hpretl/tt03-tempsensor/README.md

  

# Synthesizable Digital Temperature Sensor

**(c) 2023 Harald Pretl, Manuel Moser, and Michael Herber, Institute for Integrated Circuits, Johannes Kepler University, Linz, Austria**

This synthesized mixed-signal design is intended for inclusion in the **Tiny Tapeout 03** from **Matt Venn**. It implements a temperature sensor with a digital readout, implemented purely from digital standard cells using the `OpenLane`/`OpenROAD` RTL2GDS flow. The resolution is a relatively crude 5 degrees Celsius, but it spans a range of -30 to 120 degree Celsius. A block diagram of the Verilog-implemented design is shown below.

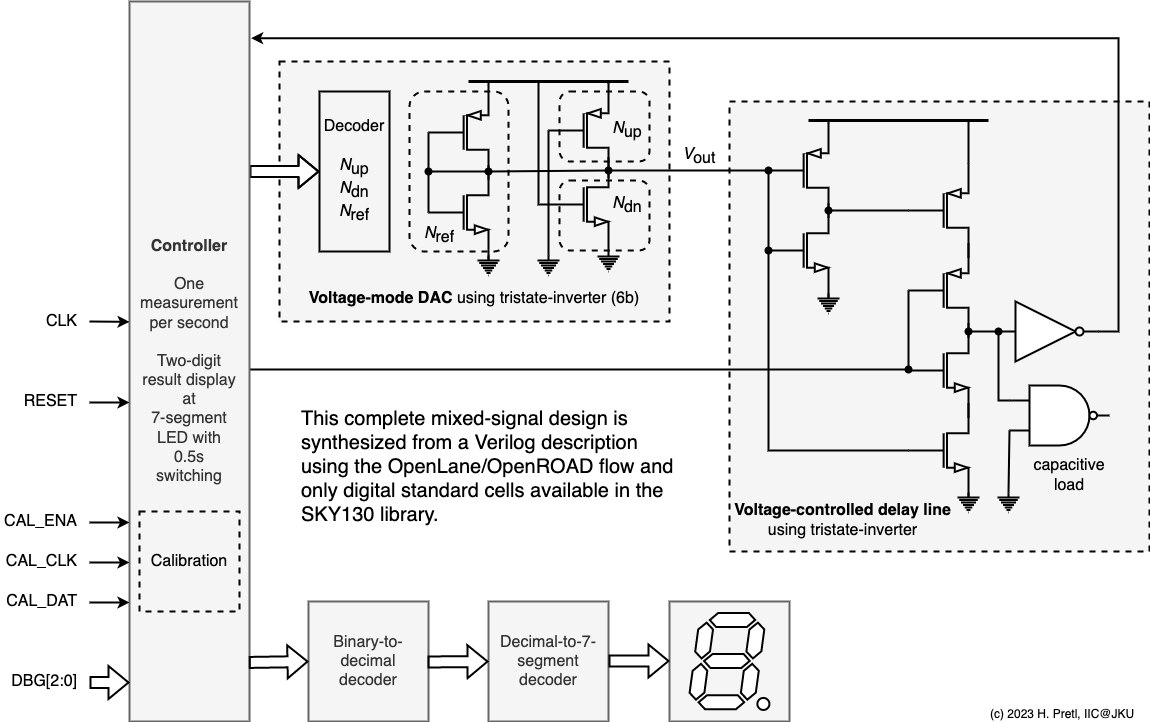
[picture p1: doc/synthesized_temperature_sensor.png]
Synthesized digital temperature sensor


The core of the circuit is the timed discharge of a pre-charged parasitic capacitor, where a MOSFET operated in subthreshold operation is used to set the strongly temperature-dependent discharge current. The subthreshold operation of a MOSFET is achieved by driving its gate with a voltage-mode digital-analog converter (DAC).

The DAC required for this temperature sensor is constructed from tristate-inverters, like the core discharge circuit. The concept of the DAC is shown in the figure below. Note that the $N_\mathrm{up}$ and the $N_\mathrm{dn}$ can be realized from the same instances by using the data inputs, whereas in the concept drawing, these are shown independently.

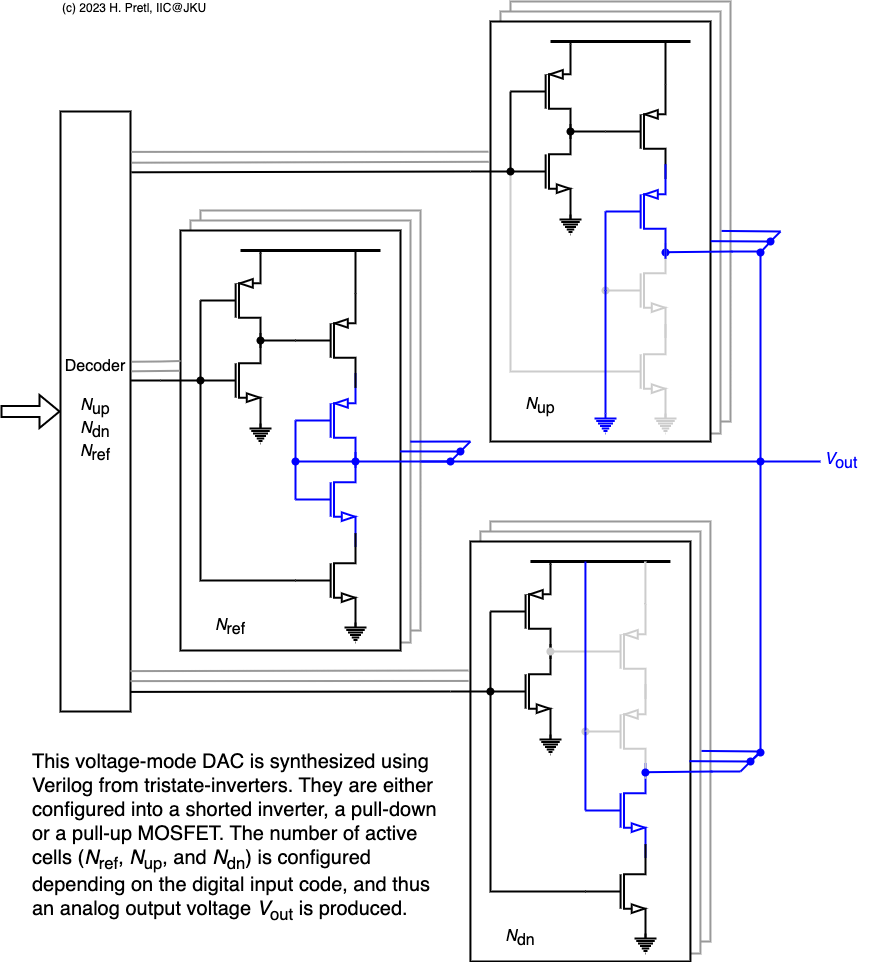
[picture p2: doc/voltage_dac.png]
Voltage-mode DAC


## What does it do?

A temperature-dependent code (a 6-bit binary value ranging from `0` to `63`) is output using an LED display in decimal mode, showing tens (dot off) and ones (dot on) (allowing a temperature range of `00` degree Celsius to `98` degree Celsius) with a measurement rate of ca. 1Hz and a display change rate of ca. 0.5Hz.

A calibration engine via a lookup table (LUT) is included to allow linearizing and calibrating the shown temperature code (the codes `0`...`31` can be translated into a code `00<<1`...`49<<1`). _(To cut the LUT size, the MSB of the raw temperature measurement is discarded, and an LSB of `0` is added to the LUT result, so only even results can be displayed.)_

Comprehensive debug modes are also implemented to monitor various internal states and signals.

## How does it work?

By creatively twisting the use of a tristate-inverter (`EINVP`), a low-resolution voltage DAC is built. This voltage-mode DAC is used in another twisted arrangement of an `EINVP` to bias an NMOS into subthreshold operation to discharge a pre-charged capacitor (the input capacitor of an inverter). Since the subthreshold current of a MOSFET is a strong function of temperature, the resulting delay time is also a function of temperature; thus, a digital temperature sensor is built. The block diagrams of the core circuits are shown above.

Using a Verilog design description, the layout is created using `OpenLane`/`OpenROAD`. The resulting layout file (the `.mag`) from `OpenLane` has been extracted using our `iic-pex.sh` [parasitic extraction script](https://github.com/iic-jku/iic-osic-tools). The resulting `.spice` file has been included in an `xschem`-based testbench for analog simulation with `ngspice`. The whole **TinyTapeout** design has been thus verified, including logic and parasitic wiring capacitors (to speed up the simulation, one of the debug modes has been used to output the digital result of the measurement directly, bypassing the binary-to-decimal decoder and the slow output via the 7-segment LED display).

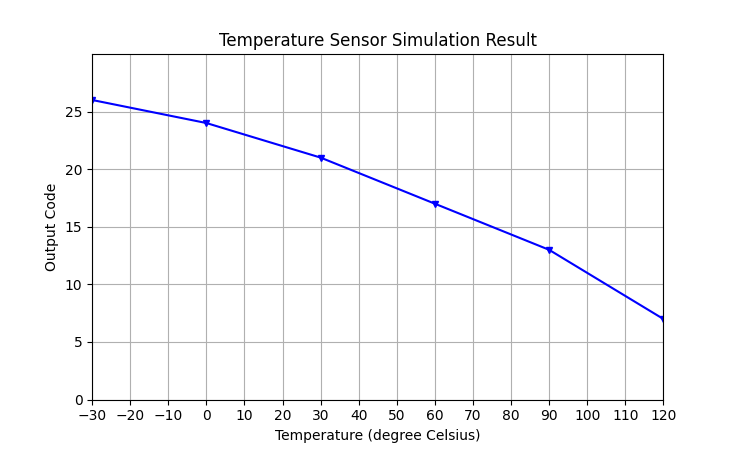
[picture p3: doc/sensor_simulation_result.png]
Digital temperature sensor simulation result


## Usage

After reset, one temperature measurement is taken per second and displayed using the LEDs. A code ranging from `00`...`63` (raw mode) or `00`...`98` degree Celcius (using the calibration engine) is shown with tens first (dot off) and ones later (dot on) with a display rate of ca. 0.5Hz.

Between measurements, the temperature sensor is turned off to minimize power consumption.

During regular operation, `io_in[7:5]` has to be set to `000`. Setting a value different from `000` enables various debug modes documented in the Verilog code.

For calibration, the internal LUT can be serially loaded as one giant serial register by using `CAL_CLK` (`io_in[2]`) and `CAL_DAT` (`io_in[3]`). Once fully loaded, the calibration engine is enabled by setting `CAL_ENA` (`io_in[4]`) to `1` (setting it to `0` displays the raw sensor code). The LUT is pre-loaded with nominal values found by simulation.
