hpretl/tt03-tempsensor/sim/simulation/tempsens_layout.png

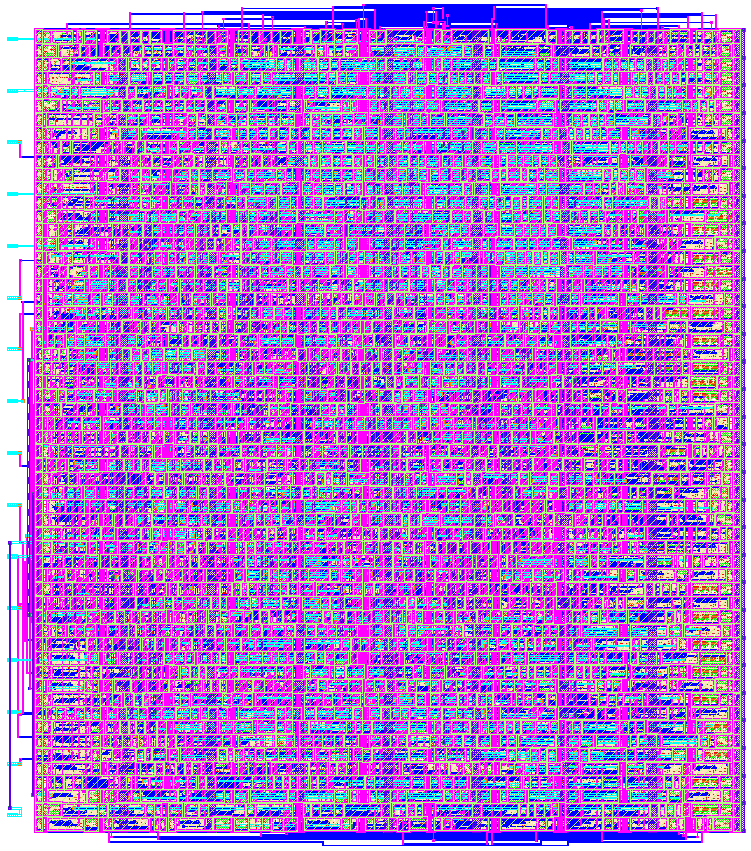
sim/simulation/tempsens_layout.png
