hpretl/tt03-tempsensor/src/test.py

import cocotb
from cocotb.clock import Clock
from cocotb.triggers import RisingEdge, FallingEdge, Timer, ClockCycles


segments = [ 63, 6, 91, 79, 102, 109, 124, 7, 127, 103 ]

@cocotb.test()
async def test_tempsens(dut):
    dut._log.info("start")
    clock = Clock(dut.clk, 100, units="us")
    cocotb.start_soon(clock.start())

    dut._log.info("configuration")
    dut.en_quick_transition.value = 0
    dut.tempsens_cfg = 3

    dut._log.info("reset")
    dut.rst.value = 1
    await ClockCycles(dut.clk, 10)
    dut.rst.value = 0

    dut._log.info("check all segments")
    for i in range(10):
        dut._log.info("check segment {}".format(i))
        await ClockCycles(dut.clk, 1000)
        assert int(dut.segments.value) == segments[i]
