hpretl/tt03-tempsensor/(commit log)

2023-04-18 Design too large, reduce calibration LUT to lower half only
    [hpretl_tt03_temperature_sensor.v]
2023-04-18 Remove calibration engine, design too large
    [hpretl_tt03_temperature_sensor.v]
2023-04-19 Reintroduce calibration LUT, with more efficient implementation now fits the area (but getting full)
2023-04-20 Prepare analog sims to check functionality vs. temp
    [tb_tempsens.sch]
2023-04-23 Pre-load calibration LUT during reset based on nominal simulation data, compress LUT to fit TT area
    [hpretl_tt03_temperature_sensor.v]
2023-12-29 Update sim environment
    [tb_tempsens.sch]
2023-12-30 Update to TB
    [tb_tempsens.sch]
2023-12-30 New TB
    [tb_tempsens.sch]
